NRhaman2000/riscv-fpga-pong/docs/images/debounce-logic.png

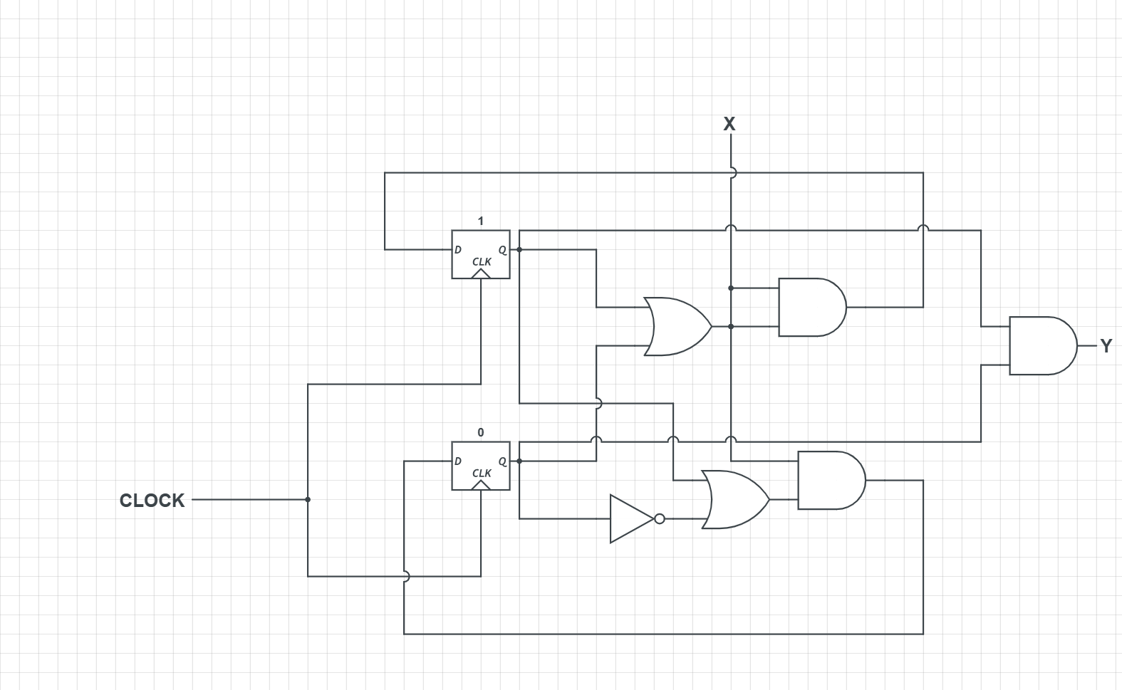
docs/images/debounce-logic.png
