NRhaman2000/riscv-fpga-pong/rtl/font8x8_min.v

// font8x8_min.v
// Minimal 8x8 font for required letters/numbers/space/?.
// bits[7] is leftmost pixel.

module font8x8_min (
    input  [7:0] ch,
    input  [2:0] row,
    output reg [7:0] bits
);
    always @(*) begin
        bits = 8'h00;

        case (ch)
            8'h20: bits = 8'h00; // space

            8'h3F: case (row) // '?'
                3'd0: bits = 8'b00111100;
                3'd1: bits = 8'b01000010;
                3'd2: bits = 8'b00000100;
                3'd3: bits = 8'b00001000;
                3'd4: bits = 8'b00010000;
                3'd5: bits = 8'b00000000;
                3'd6: bits = 8'b00010000;
                3'd7: bits = 8'b00000000;
            endcase

            // digits 0..9
            8'h30: case (row)
                3'd0: bits = 8'b00111100;
                3'd1: bits = 8'b01000010;
                3'd2: bits = 8'b01000110;
                3'd3: bits = 8'b01001010;
                3'd4: bits = 8'b01010010;
                3'd5: bits = 8'b01100010;
                3'd6: bits = 8'b00111100;
                3'd7: bits = 8'b00000000;
            endcase
            8'h31: case (row)
                3'd0: bits = 8'b00011000;
                3'd1: bits = 8'b00111000;
                3'd2: bits = 8'b00011000;
                3'd3: bits = 8'b00011000;
                3'd4: bits = 8'b00011000;
                3'd5: bits = 8'b00011000;
                3'd6: bits = 8'b00111100;
                3'd7: bits = 8'b00000000;
            endcase
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
                3'd4: bits = 8'b00011000;
                3'd5: bits = 8'b00011000;
                3'd6: bits = 8'b00011000;
                3'd7: bits = 8'b00000000;
            endcase

            default: bits = 8'h00;
        endcase
    end
endmodule
