NRhaman2000/riscv-fpga-pong/rtl/seg7.v

// seg7.v
// Active-low 7-seg patterns (gfedcba).

module seg7 (
    input  [3:0] value,
    output reg [6:0] seg
);
    always @(*) begin
        case (value)
            4'd0: seg = 7'b1000000;
            4'd1: seg = 7'b1111001;
            4'd2: seg = 7'b0100100;
            4'd3: seg = 7'b0110000;
            4'd4: seg = 7'b0011001;
            4'd5: seg = 7'b0010010;
            4'd6: seg = 7'b0000010;
            4'd7: seg = 7'b1111000;
            4'd8: seg = 7'b0000000;
            4'd9: seg = 7'b0010000;
            default: seg = 7'b1111111;
        endcase
    end
endmodule
